Krystian-Matusiak/Praca_inzynierska/Kitchen_Hall_Garage_Rooms.pdf

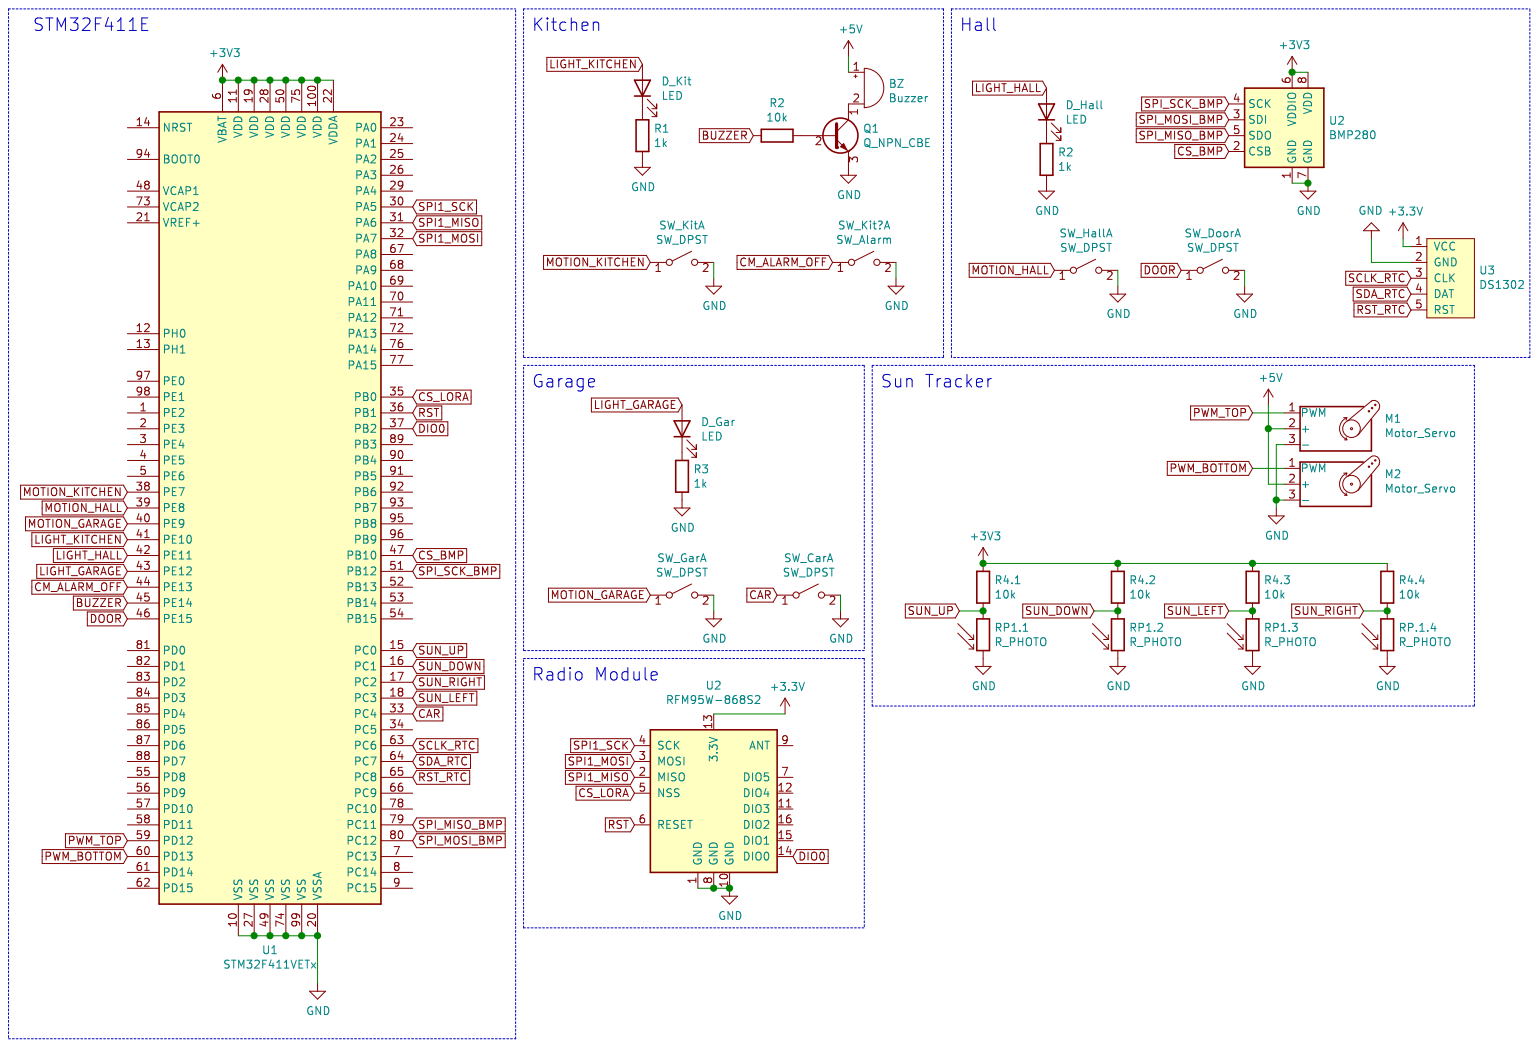
[picture p22: page 1]
