Krystian-Matusiak/Praca_inzynierska/Living_Bath_Bed_Rooms.pdf

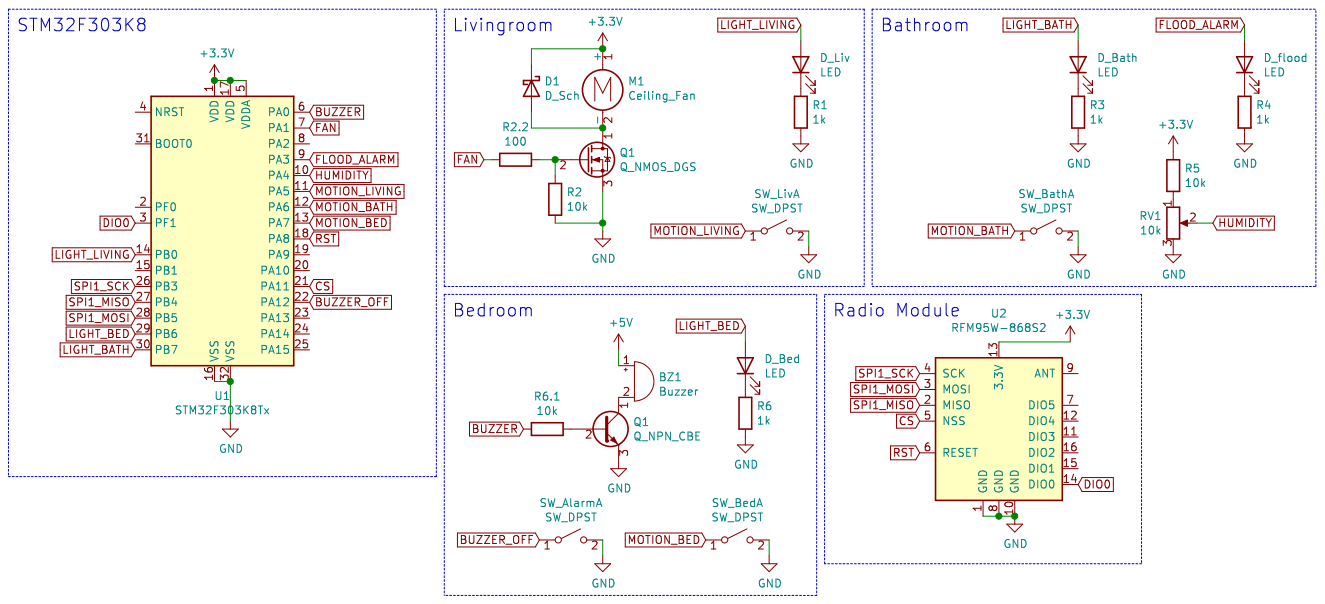
[picture p23: page 1]
