Krystian-Matusiak/Praca_inzynierska/SCHEMES/First_scheme/First_scheme.pdf

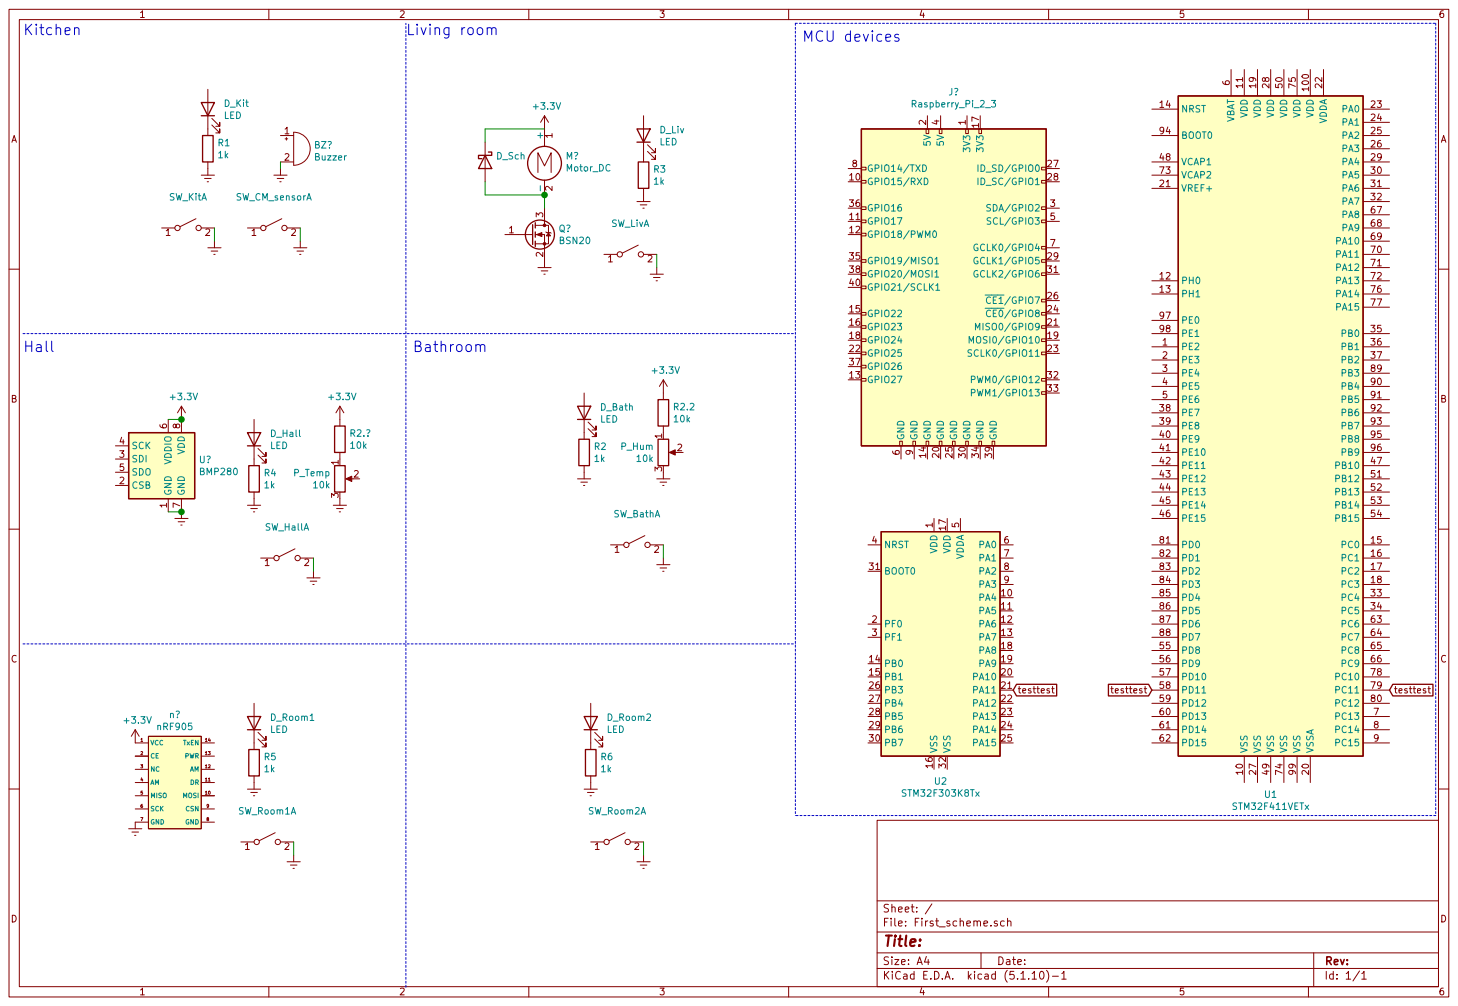
[picture p24: page 1]
