Krystian-Matusiak/Praca_inzynierska/Kitchen_Hall_Garage_Rooms/Core/Src/main.c

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
/* Includes ------------------------------------------------------------------*/
#include "main.h"
#include "cmsis_os.h"
#include "adc.h"
#include "dma.h"
#include "spi.h"
#include "tim.h"
#include "usart.h"
#include "gpio.h"

/* USER CODE BEGIN Includes */
#include "FreeRTOS.h"
#include "task.h"
#include "LoRa.h"
#include "bmp280.h"
#include "RTC.h"

/* USER CODE END Includes */

/* USER CODE BEGIN PD */

#define STM32F411_DEVICE 0x02

/* USER CODE END PD */


/* USER CODE BEGIN PV */

// -------------------------------------
// Task handlers

xTaskHandle light_kit_handle;
xTaskHandle light_hall_handle;
xTaskHandle light_gar_handle;
xTaskHandle carbon_sensor_handle;
xTaskHandle clock_handle;
xTaskHandle door_handle;
xTaskHandle car_handle;
xTaskHandle pressure_handle;
xTaskHandle sun_tracker_handle;
xTaskHandle tx_handle;
xTaskHandle rx_handle;


// -------------------------------------
// PID and sun tracker variables

typedef struct Servo{
	uint8_t Kp;
	uint8_t Ki;
	uint8_t Kd;

	int16_t P;
	int16_t I;
	int16_t D;

	int16_t error;
	int16_t prev_error;
}Servo;

Servo Top;
Servo Bottom;

void servo_init(){
	Top.Kp = 1;
	Top.Ki = 1;
	Top.Kd = 1;
	Top.error = 0;
	Top.prev_error = 0;


	Bottom.Kp = 1;
	Bottom.Ki = 1;
	Bottom.Kd = 1;
	Bottom.error = 0;
	Bottom.prev_error = 0;
}

int16_t positionTOP = 0;
int16_t positionBOTTOM = 0;

// -------------------------------------
// Boolean variables

uint8_t isKitchenEmpty=0;
uint8_t isHallEmpty=0;
uint8_t isGarageEmpty=0;
uint8_t isCar=0;
uint8_t isCMSensor=0;
uint8_t isDoorClosed=0;


// -------------------------------------
// Variables related with temperature, pressure and ph_resis

int32_t temp ;
uint32_t press;

volatile uint8_t ph_resis[4];

// -------------------------------------
// Variables related with data and time

uint8_t hours=0;
uint8_t minutes=0;
uint8_t seconds=1;

uint8_t day=0;
uint8_t month=0;
uint8_t year=0;
uint8_t day_week=0;

// -------------------------------------
// Transmit and receive buffor

// -----------------------------------------------------------------------
// tx_frame : | device | pressure | temp | clock | car | kitchen | hall | garage | CMS | door | PWM TOP | PWM BOTTOM |
//				  8bit      16bit	8bit   5x8bit  1bit   1bit	   1bit	  1bit	   1bit  1bit     8bit		8bit

uint8_t tx_frame[15]={0x02, 0x00, 0x00, 0x00, 0x00, 0x00, 0x00, 0x00, 0x00, 0x00, 0x00, 0x00, 0x00, 0x00, 0x00};
uint8_t rx_frame[6]={0x00, 0x00, 0x00, 0x00, 0x00, 0x00};

char tx_test[256] = "TEST FreeRTOS 411!      ";

// Continuous updatable time buffor
uint8_t buffor[8] = {0,1,2,3,4,5,6,7};
// Current time send

uint8_t real_time[8] = { 1 , 21 , 7 , 3 , 9 , 57 , 0 ,2 };


/* USER CODE END PV */

void SystemClock_Config(void);
void MX_FREERTOS_Init(void);
/* USER CODE BEGIN PFP */

void light_kitchen	(void *pvParameters);
void light_hall		(void *pvParameters);
void light_garage	(void *pvParameters);
void carbon_sensor	(void *pvParameters);
void clock			(void *pvParameters);
void door 			(void *pvParameters);
void car 			(void *pvParameters);
void pressure		(void *pvParameters);
void sun_tracker	(void *pvParameters);

void TX_radio		(void *pvParameters);
void RX_radio		(void *pvParameters);

/* USER CODE END PFP */

/* USER CODE BEGIN 0 */

void light_kitchen	(void *pvParameters){
	while(1){

		isKitchenEmpty = HAL_GPIO_ReadPin(MOTION_KIT_GPIO_Port, MOTION_KIT_Pin);

		if( !isKitchenEmpty ){
			HAL_GPIO_WritePin(LIGHT_KIT_GPIO_Port, LIGHT_KIT_Pin, GPIO_PIN_SET);
			tx_frame[10] = tx_frame[10] | (1<<4);
		}
		else{
			HAL_GPIO_WritePin(LIGHT_KIT_GPIO_Port, LIGHT_KIT_Pin, GPIO_PIN_RESET);
			tx_frame[10] = tx_frame[10] & ~(1<<4);
		}
		vTaskDelay( 10 / portTICK_PERIOD_MS);

	}
	vTaskDelete(NULL);
}

void light_hall		(void *pvParameters){
	while(1){

		isHallEmpty = HAL_GPIO_ReadPin(MOTION_HALL_GPIO_Port, MOTION_HALL_Pin);

		if( !isHallEmpty ){
			HAL_GPIO_WritePin(LIGHT_HALL_GPIO_Port, LIGHT_HALL_Pin, GPIO_PIN_SET);
			tx_frame[10] = tx_frame[10] | (1<<3);
		}
		else{
			HAL_GPIO_WritePin(LIGHT_HALL_GPIO_Port, LIGHT_HALL_Pin, GPIO_PIN_RESET);
			tx_frame[10] = tx_frame[10] & ~(1<<3);
		}
		vTaskDelay( 10 / portTICK_PERIOD_MS);
	}
	vTaskDelete(NULL);
}

void light_garage	(void *pvParameters){
	while(1){

		isGarageEmpty = HAL_GPIO_ReadPin(MOTION_GAR_GPIO_Port, MOTION_GAR_Pin);

		if( !isGarageEmpty ){
			HAL_GPIO_WritePin(LIGHT_GAR_GPIO_Port, LIGHT_GAR_Pin, GPIO_PIN_SET);
			tx_frame[10] = tx_frame[10] | (1<<2);
		}
		else{
			HAL_GPIO_WritePin(LIGHT_GAR_GPIO_Port, LIGHT_GAR_Pin, GPIO_PIN_RESET);
			tx_frame[10] = tx_frame[10] & ~(1<<2);
		}
		vTaskDelay( 10 / portTICK_PERIOD_MS);

	}
	vTaskDelete(NULL);
}

void carbon_sensor	(void *pvParameters){
	while(1){

		isCMSensor = HAL_GPIO_ReadPin(CMS_GPIO_Port, CMS_Pin);

		if( !isCMSensor ){
			HAL_GPIO_WritePin(CM_BUZZER_GPIO_Port, CM_BUZZER_Pin, GPIO_PIN_SET);
			tx_frame[10] = tx_frame[10] | (1<<1);
		}
		else{
			HAL_GPIO_WritePin(CM_BUZZER_GPIO_Port, CM_BUZZER_Pin, GPIO_PIN_RESET);
			tx_frame[10] = tx_frame[10] & ~(1<<1);
		}
		vTaskDelay( 5 / portTICK_PERIOD_MS);
	}
	vTaskDelete(NULL);
}

void clock			(void *pvParameters){
	while(1){
		Read_Time(buffor);

		year = buffor[1];
		month = buffor[2];
		day = buffor[7];

		hours = buffor[4];
		minutes = buffor[5];
		seconds = buffor[6];

//		year = 21;
//		month = 8;
//		day = 24;
//
//		hours = 9;
//		minutes = 1;

		tx_frame[4] = hours;
		tx_frame[5] = minutes;
		tx_frame[6] = seconds;
		tx_frame[7] = day;
		tx_frame[8] = month;
		tx_frame[9] = year;
//		seconds ++;
//		if(seconds == 60){
//			seconds=0;
//			minutes++;
//		}

//		printf("%d:%d:%d %d-%d-20%d \r\n",hours,minutes,seconds,day,month,year);
		vTaskDelay( 100 / portTICK_PERIOD_MS);
	}
	vTaskDelete(NULL);
}

void door 			(void *pvParameters){
	while(1){
		isDoorClosed = HAL_GPIO_ReadPin(DOOR_GPIO_Port, DOOR_Pin);
		if( !isDoorClosed ){
			tx_frame[10] = tx_frame[10] | (1<<5);
		}
		else{
			tx_frame[10] = tx_frame[10] & ~(1<<5);
		}
		vTaskDelay( 5 / portTICK_PERIOD_MS);
	}
	vTaskDelete(NULL);
}

void car 			(void *pvParameters){
	while(1){
		isCar = HAL_GPIO_ReadPin(CAR_GPIO_Port, CAR_Pin);
		if( !isCar )
			tx_frame[10] = tx_frame[10] | 1;
		else
			tx_frame[10] = tx_frame[10] & ~1;
		vTaskDelay( 5 / portTICK_PERIOD_MS);
	}
	vTaskDelete(NULL);
}

void pressure		(void *pvParameters){
	while(1){
		get_temp_press( &temp, &press);
		tx_frame[1] = (uint8_t)(press>>8);
		tx_frame[2] = (uint8_t)press;
		tx_frame[3] = (uint8_t)temp;

//		tx_frame[1] = 0x03;// (press>>8);
//		tx_frame[2] = 0xEF;// (uint8_t)press;
//		tx_frame[3] = 22;//temp;

//		printf("temp=%d \t cis=%d \r\n" , (int)temp , (int)press);
		vTaskDelay( 20 / portTICK_PERIOD_MS);
	}
	vTaskDelete(NULL);
}

void sun_tracker	(void *pvParameters){
	while(1){

		//-----------------------------------------------------------------
		// TOP

		Top.error = 0 - (ph_resis[0] - ph_resis[1]);

		Top.P = Top.Kp * Top.error;
		Top.I = Top.Ki * (Top.error - Top.prev_error);
		Top.D = Top.Kd * Top.error;

		Top.prev_error = Top.error;

		positionTOP += Top.P + Top.I;

		__HAL_TIM_SET_COMPARE(&htim1 , TIM_CHANNEL_1 , positionTOP );
		vTaskDelay( 20 / portTICK_PERIOD_MS);
		tx_frame[11] = positionTOP;

		//-----------------------------------------------------------------
		//BOTTOM

		Bottom.error = 0 - (ph_resis[2] - ph_resis[3]);

		Bottom.P = Bottom.Kp * Bottom.error;
		Bottom.I = Bottom.Ki * (Bottom.error - Bottom.prev_error);
		Bottom.D = Bottom.Kd * Bottom.error;

		Bottom.prev_error = Bottom.error;

		positionBOTTOM += Bottom.P + Bottom.I;

		__HAL_TIM_SET_COMPARE(&htim1 , TIM_CHANNEL_1 , positionBOTTOM );
		vTaskDelay( 20 / portTICK_PERIOD_MS);
		tx_frame[13] = positionBOTTOM;
	}
	vTaskDelete(NULL);
}


void TX_radio(void *pvParameters){
	vTaskDelay(30 / portTICK_PERIOD_MS);
	uint32_t time=0;
	while(1){

		time = HAL_GetTick();
		while( HAL_GetTick() - time < 5 ){
			Transmit(tx_frame, sizeof(tx_frame));
		}
//		Transmit(tx_frame, sizeof(tx_frame));
//		printf("test \r\n");

		vTaskResume(rx_handle);
		vTaskSuspend( NULL );
	}
	vTaskDelete(NULL);
}


void RX_radio(void *pvParameters){
	uint32_t time=0;
	set_OPMODE(OPMODE_RX);
	while(1){
		vTaskSuspend(tx_handle);

		set_OPMODE(OPMODE_RX);
		while(	HAL_GPIO_ReadPin(DIO0_GPIO_Port, DIO0_Pin) != GPIO_PIN_SET){}

		if( HAL_GPIO_ReadPin(DIO0_GPIO_Port, DIO0_Pin) == GPIO_PIN_SET ){
			Receive(rx_frame);
//			printf("Carrier found. \r\n");

			if( rx_frame[0] == 0x01 && rx_frame[1] == STM32F411_DEVICE){
				vTaskResume(tx_handle);
				vTaskSuspend( NULL );

				Write_Reg(REG_HOP_PERIOD,0x00);
				Write_Reg(RegDioMapping1, MAP_DIO0_LORA_RXDONE|MAP_DIO1_LORA_NOP|MAP_DIO2_LORA_NOP);
				Write_Reg(REG_IRQ_FLAGS, 0xFF);
				Write_Reg(REG_IRQ_FLAGS_MASK, ~IRQ_LORA_RXDONE_MASK);
				Write_Reg(REG_FIFO_RX_BASE_AD, 0x00);
				Write_Reg(REG_FIFO_ADDR_PTR, 0x00);
			}
			printf("RPI data = %d - %d - %d \r\n" , rx_frame[0], rx_frame[1], rx_frame[2]);
		}
		else{
			printf("No carrier found. \r\n");
		}
		rx_frame[0]=0x00;
		rx_frame[1]=0x00;

	}
	vTaskDelete(NULL);
}




/* USER CODE END 0 */

/**
  * @brief  The application entry point.
  * @retval int
  */
int main(void)
{
  /* MCU Configuration--------------------------------------------------------*/

  /* Reset of all peripherals, Initializes the Flash interface and the Systick. */
  HAL_Init();

  /* Configure the system clock */
  SystemClock_Config();

  /* Initialize all configured peripherals */
  MX_GPIO_Init();
  MX_SPI1_Init();
  MX_DMA_Init();
  MX_ADC1_Init();
  MX_USART2_UART_Init();
  MX_SPI3_Init();
  MX_TIM4_Init();
  /* USER CODE BEGIN 2 */

  // Sun tracker (PWM and ADC) init
//  HAL_TIM_PWM_Start(&htim1, TIM_CHANNEL_1);
//  HAL_TIM_PWM_Start(&htim1, TIM_CHANNEL_2);
//  HAL_ADC_Start_DMA(&hadc1, ph_resis, 4);

  // Setting up BMP280
  reset();
  BMP280_setup();
  setConstants();

  // Setting up Real Time Clock
  RTC_Init();
  Write_Zero_Seconds();

  // Servo struct definition
  servo_init();

  // Setting up LoRa
  LoRa_init(868);
  tx_frame[0] = STM32F411_DEVICE;



  xTaskCreate( TX_radio			, "RADIO_TRANSMIT_TASK"		, 250, NULL, 1, &tx_handle );
  xTaskCreate( RX_radio			, "RADIO_RECEIVE_TASK"		, 250, NULL, 1, &rx_handle );
  xTaskCreate( pressure			, "PRESSURE_TASK"			, 230, NULL, 1, &pressure_handle );
  xTaskCreate( clock			, "CLOCK_TASK"				, 220, NULL, 1, &clock_handle );

  xTaskCreate( door				, "DOOR_TASK"				, 90, NULL, 1, &door_handle );
  xTaskCreate( car				, "CAR_TASK"				, 90, NULL, 1, &car_handle );
  xTaskCreate( carbon_sensor	, "CARBON_SENSOR_TASK" 		, 100, NULL, 1, &carbon_sensor_handle );

  xTaskCreate( light_kitchen	, "LIGHT_KITCHEN_TASK"		, 70, NULL, 1, &light_kit_handle );
  xTaskCreate( light_hall		, "LIGHT_HALL_TASK"			, 70, NULL, 1, &light_hall_handle );
  xTaskCreate( light_garage		, "LIGHT_GARAGE_TASK"		, 70, NULL, 1, &light_gar_handle );

//  xTaskCreate( sun_tracker		, "SUN_TRACKER_TASK"		, 150, NULL, 1, &sun_tracker_handle);

  vTaskStartScheduler();

  /* USER CODE END 2 */

  /* Init scheduler */
  osKernelInitialize();  /* Call init function for freertos objects (in freertos.c) */
  MX_FREERTOS_Init();
  /* Start scheduler */
  osKernelStart();

  /* We should never get here as control is now taken by the scheduler */
  /* Infinite loop */
  /* USER CODE BEGIN WHILE */


  while (1)
  {
	vTaskDelay( 10 / portTICK_PERIOD_MS);

    /* USER CODE END WHILE */

    /* USER CODE BEGIN 3 */
  }
  /* USER CODE END 3 */
}

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
