Krystian-Matusiak/Praca_inzynierska/Kitchen_Hall_Garage_Rooms/Core/Inc/main.h

#define SUN_UP_Pin GPIO_PIN_0
#define SUN_UP_GPIO_Port GPIOC
#define SUN_DOWN_Pin GPIO_PIN_1
#define SUN_DOWN_GPIO_Port GPIOC
#define SUN_RIGHT_Pin GPIO_PIN_2
#define SUN_RIGHT_GPIO_Port GPIOC
#define SUN_LEFT_Pin GPIO_PIN_3
#define SUN_LEFT_GPIO_Port GPIOC
#define CAR_Pin GPIO_PIN_4
#define CAR_GPIO_Port GPIOC
#define CS_LORA_Pin GPIO_PIN_0
#define CS_LORA_GPIO_Port GPIOB
#define RST_Pin GPIO_PIN_1
#define RST_GPIO_Port GPIOB
#define DIO0_Pin GPIO_PIN_2
#define DIO0_GPIO_Port GPIOB
#define MOTION_KIT_Pin GPIO_PIN_7
#define MOTION_KIT_GPIO_Port GPIOE
#define MOTION_HALL_Pin GPIO_PIN_8
#define MOTION_HALL_GPIO_Port GPIOE
#define MOTION_GAR_Pin GPIO_PIN_9
#define MOTION_GAR_GPIO_Port GPIOE
#define LIGHT_KIT_Pin GPIO_PIN_10
#define LIGHT_KIT_GPIO_Port GPIOE
#define LIGHT_HALL_Pin GPIO_PIN_11
#define LIGHT_HALL_GPIO_Port GPIOE
#define LIGHT_GAR_Pin GPIO_PIN_12
#define LIGHT_GAR_GPIO_Port GPIOE
#define CMS_Pin GPIO_PIN_13
#define CMS_GPIO_Port GPIOE
#define CM_BUZZER_Pin GPIO_PIN_14
#define CM_BUZZER_GPIO_Port GPIOE
#define DOOR_Pin GPIO_PIN_15
#define DOOR_GPIO_Port GPIOE
#define CS_BMP_Pin GPIO_PIN_10
#define CS_BMP_GPIO_Port GPIOB
#define PWM_TOP_Pin GPIO_PIN_12
#define PWM_TOP_GPIO_Port GPIOD
#define PWM_BOTTOM_Pin GPIO_PIN_13
#define PWM_BOTTOM_GPIO_Port GPIOD
#define SCLK_RTC_Pin GPIO_PIN_6
#define SCLK_RTC_GPIO_Port GPIOC
#define SDA_RTC_Pin GPIO_PIN_7
#define SDA_RTC_GPIO_Port GPIOC
#define RST_RTC_Pin GPIO_PIN_8
#define RST_RTC_GPIO_Port GPIOC
