Krystian-Matusiak/Praca_inzynierska/Living_Bath_Bed_Rooms/Core/Src/main.c

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
/* Includes ------------------------------------------------------------------*/
#include "main.h"
#include "cmsis_os.h"
#include "adc.h"
#include "spi.h"
#include "tim.h"
#include "usart.h"
#include "gpio.h"

/* USER CODE BEGIN Includes */


#include <stdio.h>
#include <string.h>
#include <semphr.h>
#include "FreeRTOS.h"
#include "task.h"
#include "LoRa.h"

/* USER CODE END Includes */

/* USER CODE BEGIN PD */

#define TEMP_THRESHOLD 24
#define HUMID_THRESHOLD 80

#define STM32F303K8_DEVICE 0x03

/* USER CODE END PD */


/* USER CODE BEGIN PV */

// -------------------------------------
// Task handlers

xTaskHandle light_liv_handle;
xTaskHandle light_bed_handle;
xTaskHandle light_bath_handle;
xTaskHandle light_fl_handle;
xTaskHandle light_alarm_handle;
xTaskHandle radio_module_handle;
xTaskHandle fan_handle;
xTaskHandle tx_handle;
xTaskHandle rx_handle;


// -------------------------------------
// Boolean variables

uint8_t isLivingroomEmpty=0;
uint8_t isBathroomEmpty=0;
uint8_t isBedroomEmpty=0;
uint8_t isFlood=0;
uint8_t isAlarmOn=0;
uint8_t isAlarmOff=0;


// -------------------------------------
// Variables related with temperature and humidity

uint8_t temperature=0;

uint8_t humidity_measure=0;
uint8_t humidity=0;

// -------------------------------------
// Variables related with data and time

uint8_t hours=-1;
uint8_t minutes=-1;
uint8_t day=-1;
uint8_t month=-1;

uint8_t alarm_hours=0;
uint8_t alarm_minutes=0;
uint8_t alarm_day=0;
uint8_t alarm_month=0;


// -------------------------------------
// Transmit and receive buffor

// -------------------------------------
// tx_frame : | device | humidity | livingroom | bathroom | bedroom | alarm switch-off | alarm active |  fan  |
//				  8bit      8bit	   	1bit		1bit		1bit		  1bit				1bit	 1bit

uint8_t tx_frame[3] = { 0x03 , 0x00 , 0b00000000 };
uint8_t rx_frame[15]= {0 ,0 ,0 ,0 ,0 ,0 ,0 ,0 ,0 ,0 ,0 ,0 ,0 ,0 ,0};

char tx_test[256] = "TEST FreeRTOS 303!      ";


// Continuous updatable time buffor
uint8_t buffor[8] = {0,1,2,3,4,5,6,7};

// Current time send
uint8_t real_time[8] = { 1 , 21 , 7 , 3 , 13 , 20 , 0 ,2};


//static SemaphoreHandle_t mutex;



/* USER CODE END PV */

void SystemClock_Config(void);
void MX_FREERTOS_Init(void);
/* USER CODE BEGIN PFP */
void light_livingroom   (void *pvParameters);
void light_bathroom   	(void *pvParameters);
void light_bedroom   	(void *pvParameters);
void ceiling_fan		(void *pvParameters);
void flood_protection 	(void *pvParameters);
void alarm_clock		(void *pvParameters);
void radio_module		(void *pvParameters);

void TX_radio		(void *pvParameters);
void RX_radio		(void *pvParameters);


/* USER CODE END PFP */

/* USER CODE BEGIN 0 */



void light_livingroom   (void *pvParameters){
	while(1){

		isLivingroomEmpty = HAL_GPIO_ReadPin(MOTION_LIVING_GPIO_Port, MOTION_LIVING_Pin);

		if( !isLivingroomEmpty ){
			HAL_GPIO_WritePin(LIGHT_LIVING_GPIO_Port, LIGHT_LIVING_Pin, GPIO_PIN_SET);
			tx_frame[2] = tx_frame[2] | (1<<5);
		}
		else{
			HAL_GPIO_WritePin(LIGHT_LIVING_GPIO_Port, LIGHT_LIVING_Pin, GPIO_PIN_RESET);
			tx_frame[2] = tx_frame[2] & ~(1<<5);
		}
		vTaskDelay( 10 / portTICK_PERIOD_MS);
	}
	vTaskDelete(NULL);
}
int a=0;
void light_bathroom   	(void *pvParameters){
	while(1){

		isBathroomEmpty = HAL_GPIO_ReadPin(MOTION_BATH_GPIO_Port, MOTION_BATH_Pin);

		if( !isBathroomEmpty ){
			HAL_GPIO_WritePin(LIGHT_BATH_GPIO_Port, LIGHT_BATH_Pin, GPIO_PIN_SET);
			tx_frame[2] = tx_frame[2] | (1<<4);
		}
		else{
			HAL_GPIO_WritePin(LIGHT_BATH_GPIO_Port, LIGHT_BATH_Pin, GPIO_PIN_RESET);
			tx_frame[2] = tx_frame[2] & ~(1<<4);
		}
		vTaskDelay( 10 / portTICK_PERIOD_MS);
	}
	vTaskDelete(NULL);
}

void light_bedroom   	(void *pvParameters){
	while(1){

		isBedroomEmpty = HAL_GPIO_ReadPin(MOTION_BED_GPIO_Port, MOTION_BED_Pin);

		if( !isBedroomEmpty ){
			HAL_GPIO_WritePin(LIGHT_BED_GPIO_Port, LIGHT_BED_Pin, GPIO_PIN_SET);
			tx_frame[2] = tx_frame[2] | (1<<3);
		}
		else{
			HAL_GPIO_WritePin(LIGHT_BED_GPIO_Port, LIGHT_BED_Pin, GPIO_PIN_RESET);
			tx_frame[2] = tx_frame[2] & ~(1<<3);
		}
		vTaskDelay( 10 / portTICK_PERIOD_MS);
	}
	vTaskDelete(NULL);
}



void ceiling_fan 	 	(void *pvParameters){
	while(1){
		if( temperature > TEMP_THRESHOLD ){
			HAL_GPIO_WritePin(FAN_GPIO_Port, FAN_Pin, GPIO_PIN_SET);
			tx_frame[2] = tx_frame[2] | 1;
		}
		else{
			HAL_GPIO_WritePin(FAN_GPIO_Port, FAN_Pin, GPIO_PIN_RESET);
			tx_frame[2] = tx_frame[2] & ~1;
		}

		vTaskDelay( 10 / portTICK_PERIOD_MS);
	}
	vTaskDelete(NULL);
}

void flood_protection 	(void *pvParameters){
	while(1){
		  HAL_ADC_Start(&hadc2);
		  vTaskDelay( 10 / portTICK_PERIOD_MS);

		  //humidity_measure = HAL_ADC_GetValue(&hadc2);
		  humidity = (HAL_ADC_GetValue(&hadc2) * 70)/113 + 20;

		  if(humidity > 90)
			  humidity = 90;

		  if( humidity >= 50)
			HAL_GPIO_WritePin(FLOOD_ALARM_GPIO_Port, FLOOD_ALARM_Pin, GPIO_PIN_SET);
		  else
			HAL_GPIO_WritePin(FLOOD_ALARM_GPIO_Port, FLOOD_ALARM_Pin, GPIO_PIN_RESET);

//		if( rx_frame[0] == 0x02){
//			printf("STM32F411 data = %d - %d - %d - %d \r\n" , rx_frame[4], rx_frame[5], rx_frame[8], rx_frame[7]);
//			printf("alarm = %d - %d - %d - %d\r\n" , alarm_day, alarm_month, alarm_hours, alarm_minutes);
//		}
	}
	vTaskDelete(NULL);
}

void alarm_clock		(void *pvParameters){
	while(1){

		if( 	!isAlarmOff
				&& day == alarm_day
				&& month == alarm_month
				&& hours == alarm_hours
				&& minutes == alarm_minutes
				&& HAL_GPIO_ReadPin(BUZZER_OFF_GPIO_Port, BUZZER_OFF_Pin) != GPIO_PIN_RESET){

			HAL_GPIO_WritePin(BUZZER_GPIO_Port, BUZZER_Pin, GPIO_PIN_SET);
			tx_frame[2] = tx_frame[2] | (1<<1);
			isAlarmOn=1;
		}
		if(		day != alarm_day
				&& month != alarm_month
				&& hours != alarm_hours
				&& minutes != alarm_minutes
				){
			isAlarmOff=0;
			tx_frame[2] = tx_frame[2] & ~(1<<2);
		}

		if( isAlarmOn && HAL_GPIO_ReadPin(BUZZER_OFF_GPIO_Port, BUZZER_OFF_Pin) == GPIO_PIN_RESET ){
			HAL_GPIO_WritePin(BUZZER_GPIO_Port, BUZZER_Pin, GPIO_PIN_RESET);
			tx_frame[2] = tx_frame[2] | (1<<2);
			tx_frame[2] = tx_frame[2] & ~(1<<1);
			isAlarmOff = 1;
			isAlarmOn  = 0;

			alarm_day=0;
			alarm_month=0;
			alarm_hours=0;
			alarm_minutes=0;

			vTaskDelay( 200 / portTICK_PERIOD_MS);
//			alarm_off=0;
		}

		vTaskDelay( 10 / portTICK_PERIOD_MS);
	}
	vTaskDelete(NULL);
}

void TX_radio(void *pvParameters){
	vTaskDelay(30 / portTICK_PERIOD_MS);
	uint32_t time=0;
	while(1){

		tx_frame[1] = humidity;
		time = HAL_GetTick();
		while( HAL_GetTick() - time < 5 ){
			Transmit(tx_frame, sizeof(tx_frame));
		}

//		HAL_GPIO_WritePin(LIGHT_BATH_GPIO_Port, LIGHT_BATH_Pin, GPIO_PIN_SET);

		vTaskResume(rx_handle);
		vTaskSuspend( NULL );
		vTaskDelay( 1/ portTICK_PERIOD_MS);
	}
	vTaskDelete(NULL);
}

void RX_radio(void *pvParameters){
	uint32_t time=0;
	set_OPMODE(OPMODE_RX);
	while(1){
		vTaskSuspend(tx_handle);

		set_OPMODE(OPMODE_RX);
		while(	HAL_GPIO_ReadPin(DIO0_GPIO_Port, DIO0_Pin) != GPIO_PIN_SET){
//			printf("Waiting \r\n");
		}

		if( HAL_GPIO_ReadPin(DIO0_GPIO_Port, DIO0_Pin) == GPIO_PIN_SET ){
			Receive(rx_frame);

			if( rx_frame[0] == 0x02 ){
				day=rx_frame[7];
				month=rx_frame[8];
				hours=rx_frame[4];
				minutes=rx_frame[5];

				temperature=rx_frame[3];
				printf("\nSTM32F411 data = %d - %d - %d - %d \r\n" , rx_frame[4], rx_frame[5], rx_frame[8], rx_frame[7]);

			}

			if( rx_frame[0] == 0x01 && rx_frame[1] == STM32F303K8_DEVICE){

				if( !isAlarmOff){
					alarm_day=rx_frame[2];
					alarm_month=rx_frame[3];
					alarm_hours=rx_frame[4];
					alarm_minutes=rx_frame[5];
				}

				vTaskResume(tx_handle);
				vTaskSuspend( NULL );

				Write_Reg(REG_HOP_PERIOD,0x00);
				Write_Reg(RegDioMapping1, MAP_DIO0_LORA_RXDONE|MAP_DIO1_LORA_NOP|MAP_DIO2_LORA_NOP);
				Write_Reg(REG_IRQ_FLAGS, 0xFF);
				Write_Reg(REG_IRQ_FLAGS_MASK, ~IRQ_LORA_RXDONE_MASK);
				Write_Reg(REG_FIFO_RX_BASE_AD, 0x00);
				Write_Reg(REG_FIFO_ADDR_PTR, 0x00);

				printf("alarm = %d - %d - %d - %d\r\n\n" , alarm_day, alarm_month, alarm_hours, alarm_minutes);
			}
		}
		else{
			printf("No carrier found. \r\n");
		}
		rx_frame[0]=0x00;
		rx_frame[1]=0x00;

		vTaskDelay(5 / portTICK_PERIOD_MS);
	}
	vTaskDelete(NULL);
}


/* USER CODE END 0 */

/**
  * @brief  The application entry point.
  * @retval int
  */
int main(void)
{
  /* MCU Configuration--------------------------------------------------------*/

  /* Reset of all peripherals, Initializes the Flash interface and the Systick. */
  HAL_Init();

  /* Configure the system clock */
  SystemClock_Config();

  /* Initialize all configured peripherals */
  MX_GPIO_Init();
  MX_SPI1_Init();
  MX_ADC2_Init();
  MX_USART1_UART_Init();
  MX_TIM6_Init();
  /* USER CODE BEGIN 2 */


  // Start ADC
  HAL_ADC_Start(&hadc2);

  // Buzzer OFF
  HAL_GPIO_WritePin(BUZZER_GPIO_Port, BUZZER_Pin, GPIO_PIN_RESET);

  // Setting up LoRa
  LoRa_init(868);
  tx_frame[0] = STM32F303K8_DEVICE;

  xTaskCreate( flood_protection , "FLOOD_PROTECTION_TASK"	, 180, NULL, 1, &light_fl_handle );
  xTaskCreate( TX_radio			, "RADIO_TRANSMIT_TASK"		, 150, NULL, 1, &tx_handle );
  xTaskCreate( RX_radio			, "RADIO_RECEIVE_TASK"		, 250, NULL, 1, &rx_handle );

  xTaskCreate( alarm_clock		, "ALARM_CLOCK_TASK"		, 90, NULL, 1, &light_alarm_handle );
  xTaskCreate( ceiling_fan		, "CEILING_FAN_TASK" 		, 90, NULL, 1, &fan_handle );

  xTaskCreate( light_livingroom	, "LIGHT_LIVINGROOM_TASK"	, 70, NULL, 1, &light_liv_handle );
  xTaskCreate( light_bathroom	, "LIGHT_BATHROOM_TASK"		, 70, NULL, 1, &light_bath_handle );
  xTaskCreate( light_bedroom	, "LIGHT_BEDROOM_TASK"		, 70, NULL, 1, &light_bed_handle );



  vTaskStartScheduler();

  /* USER CODE END 2 */

  /* Init scheduler */
  osKernelInitialize();  /* Call init function for freertos objects (in freertos.c) */
  MX_FREERTOS_Init();
  /* Start scheduler */
  osKernelStart();

  /* We should never get here as control is now taken by the scheduler */
  /* Infinite loop */
  /* USER CODE BEGIN WHILE */



  while (1)
  {
	vTaskDelay( 2 / portTICK_PERIOD_MS);

    /* USER CODE END WHILE */

    /* USER CODE BEGIN 3 */
  }
  /* USER CODE END 3 */
}

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
