Krystian-Matusiak/Praca_inzynierska/Modules/LoRa_303/Core/Src/main.c

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
/* Includes ------------------------------------------------------------------*/
#include "main.h"
#include "spi.h"
#include "usart.h"
#include "gpio.h"

/* USER CODE BEGIN PD */


// Registers

#define REG_FIFO                    0x00
#define REG_OPMODE                  0x01

#define REG_FIFO_ADDR_PTR           0x0D
#define REG_FIFO_TX_BASE_AD         0x0E
#define REG_FIFO_RX_BASE_AD         0x0F

#define REG_RX_NB_BYTES             0x13
#define REG_FIFO_RX_CURRENT_ADDR    0x10
#define REG_IRQ_FLAGS               0x12
#define REG_DIO_MAPPING_1           0x40
#define REG_DIO_MAPPING_2           0x41
#define REG_MODEM_CONFIG            0x1D
#define REG_MODEM_CONFIG2           0x1E
#define REG_MODEM_CONFIG3           0x26
#define REG_SYMB_TIMEOUT_LSB  		0x1F
#define REG_PKT_SNR_VALUE			0x19
#define REG_PAYLOAD_LENGTH          0x22
#define REG_IRQ_FLAGS_MASK          0x11
#define REG_MAX_PAYLOAD_LENGTH 		0x23
#define REG_HOP_PERIOD              0x24
#define REG_SYNC_WORD				0x39
#define REG_VERSION	  				0x42

#define PAYLOAD_LENGTH              0x40


// ----------------------------------------
// Constants for radio registers
#define OPMODE_LORA      0x80
#define OPMODE_MASK      0x07
#define OPMODE_SLEEP     0x00
#define OPMODE_STANDBY   0x01
#define OPMODE_FSTX      0x02
#define OPMODE_TX        0x03
#define OPMODE_FSRX      0x04
#define OPMODE_RX        0x05
#define OPMODE_RX_SINGLE 0x06
#define OPMODE_CAD       0x07


// FRF
#define        REG_FRF_MSB              0x06
#define        REG_FRF_MID              0x07
#define        REG_FRF_LSB              0x08

#define        FRF_MSB                  0xD9 // 868.1 Mhz
#define        FRF_MID                  0x06
#define        FRF_LSB                  0x66


// ----------------------------------------
// Bits masking the corresponding IRQs from the radio
#define IRQ_LORA_RXTOUT_MASK 0x80
#define IRQ_LORA_RXDONE_MASK 0x40
#define IRQ_LORA_CRCERR_MASK 0x20
#define IRQ_LORA_HEADER_MASK 0x10
#define IRQ_LORA_TXDONE_MASK 0x08
#define IRQ_LORA_CDDONE_MASK 0x04
#define IRQ_LORA_FHSSCH_MASK 0x02
#define IRQ_LORA_CDDETD_MASK 0x01


// DIO function mappings                D0D1D2D3
#define MAP_DIO0_LORA_RXDONE   0x00  // 00------
#define MAP_DIO0_LORA_TXDONE   0x40  // 01------
#define MAP_DIO1_LORA_RXTOUT   0x00  // --00----
#define MAP_DIO1_LORA_NOP      0x30  // --11----
#define MAP_DIO2_LORA_NOP      0xC0  // ----11--

// LOW NOISE AMPLIFIER
#define REG_LNA			0x0C
#define LNA_MAX_GAIN	0x23
#define LNA_OFF_GAIN	0x00
#define LNA_LOW_GAIN	0x20

#define RegDioMapping1	0x40 // common
#define RegDioMapping2	0x41 // common

#define RegPaConfig		0x09 // common
#define RegPaRamp		0x0A // common
#define RegPaDac		0x5A // common


/* USER CODE END PD */


/* USER CODE BEGIN PV */

char rx_data[256];
char tx_data[256] = "Hello ! STM32F303K8 !";
unsigned char hello[32];// = "HELLO! ";

unsigned char receivedbytes;

/* USER CODE END PV */

void SystemClock_Config(void);
/* USER CODE BEGIN PFP */


void 	SPI_CS_LOW		();
void 	SPI_CS_HIGH		();

unsigned char Read_Reg		(unsigned char addr);
void 	Write_Reg		(unsigned char addr , unsigned char value);
void 	Write_Buf		(unsigned char addr, unsigned char *value, unsigned char len);

void 	set_OPMODE		(uint8_t mode);
void 	set_LoRa_mode	();
void 	set_Freq		(uint64_t freq);
void 	set_config		();
void 	set_Power		(int8_t pw);

uint8_t Receive		(char * payload);
void 	Transmit	(unsigned char *frame, unsigned char datalen);



/* USER CODE END PFP */

/* USER CODE BEGIN 0 */


int _write(int file , char *ptr , int len){
  HAL_UART_Transmit(&huart1 , ptr , len , 50);
  return len;
}

void SPI_CS_LOW(){
	HAL_GPIO_WritePin(CS_GPIO_Port, CS_Pin, GPIO_PIN_RESET);
}

void SPI_CS_HIGH(){
	HAL_GPIO_WritePin(CS_GPIO_Port, CS_Pin, GPIO_PIN_SET);
}

unsigned char Read_Reg(unsigned char addr){
	uint8_t reg = addr & 0x7F;
	uint8_t data;

	SPI_CS_LOW();
	HAL_SPI_Transmit(&hspi1, &reg, 1 , HAL_MAX_DELAY);
	HAL_SPI_Receive(&hspi1, &data, 1, HAL_MAX_DELAY);
	SPI_CS_HIGH();

	return data;
}

void Write_Reg(unsigned char addr , unsigned char value){
	uint8_t reg = addr | 0x80;
	uint8_t Value = value;

	SPI_CS_LOW();
	HAL_SPI_Transmit(&hspi1, &reg,	1 , HAL_MAX_DELAY);
	HAL_SPI_Transmit(&hspi1, &Value,1 , HAL_MAX_DELAY);
	SPI_CS_HIGH();
}

void set_OPMODE(uint8_t mode){
	Write_Reg(REG_OPMODE, Read_Reg(REG_OPMODE) & ~OPMODE_MASK | mode );
}

void set_LoRa_mode(){
	set_OPMODE(OPMODE_SLEEP);
	HAL_Delay(15);

	uint8_t data = OPMODE_LORA;
	Write_Reg(REG_OPMODE, data);
}

void set_Freq(uint64_t freq){
	set_OPMODE(OPMODE_SLEEP);
	HAL_Delay(15);

	uint64_t frf = (( uint64_t)freq <<14 );  // freq *  2^19 / 32
	Write_Reg(REG_FRF_MSB, (uint8_t)(frf>>16) );
	Write_Reg(REG_FRF_MID, (uint8_t)(frf>>8) );
	Write_Reg(REG_FRF_LSB, (uint8_t)(frf>>0) );
}

void set_config(){
	set_OPMODE(OPMODE_SLEEP);
	HAL_Delay(15);

	set_LoRa_mode();

	unsigned char version = Read_Reg(REG_VERSION);

	printf("%d version \n\r", version);

	Write_Reg(REG_SYNC_WORD, 0x34);


	Write_Reg(REG_MODEM_CONFIG3,0x04);
	Write_Reg(REG_MODEM_CONFIG,0x72);
	Write_Reg(REG_MODEM_CONFIG2, (0x07<<4) | 0x04);

	Write_Reg(REG_SYMB_TIMEOUT_LSB,0x08);

	Write_Reg(REG_MAX_PAYLOAD_LENGTH, 0x80);
	Write_Reg(REG_PAYLOAD_LENGTH, PAYLOAD_LENGTH);
	Write_Reg(REG_HOP_PERIOD, 0xFF);
	Write_Reg(REG_FIFO_ADDR_PTR, Read_Reg(REG_FIFO_TX_BASE_AD));

	Write_Reg(REG_LNA, LNA_MAX_GAIN);
}

uint8_t Receive(char *payload){
	Write_Reg(REG_IRQ_FLAGS, 0x40);

	int IRQ = Read_Reg(REG_IRQ_FLAGS);

	if(( IRQ & 0x20) == 0x20){
		printf("CRC error \n\r");
		Write_Reg(REG_IRQ_FLAGS, 0x20);
		return 0;
	}
	else {
		uint8_t currentAddr = Read_Reg(REG_FIFO_RX_CURRENT_ADDR);
		uint8_t receivedCount = Read_Reg(REG_RX_NB_BYTES);
		receivedbytes = receivedCount;

		Write_Reg(REG_FIFO_ADDR_PTR, currentAddr);

		for(int i = 0; i < receivedCount; i++)
			payload[i] = (char)Read_Reg(REG_FIFO);
	}

	return 1;
}

void Write_Buf(unsigned char addr, unsigned char *value, unsigned char len) {

	uint8_t reg = addr | 0x80;
	uint8_t buf[256];
	for (int i = 0; i < len; i++) {
		buf[i] = value[i];
	}

	SPI_CS_LOW();
	HAL_SPI_Transmit(&hspi1, &reg, 1, HAL_MAX_DELAY);
	HAL_SPI_Transmit(&hspi1, buf, len, HAL_MAX_DELAY);
	SPI_CS_HIGH();
}

void Transmit(unsigned char *frame, unsigned char datalen) {

	Write_Reg(REG_HOP_PERIOD,0x00);
	Write_Reg(RegDioMapping1, MAP_DIO0_LORA_TXDONE|MAP_DIO1_LORA_NOP|MAP_DIO2_LORA_NOP);
	Write_Reg(REG_IRQ_FLAGS, 0xFF);
	Write_Reg(REG_IRQ_FLAGS_MASK, ~IRQ_LORA_TXDONE_MASK);

	Write_Reg(REG_FIFO_TX_BASE_AD, 0x00);
	Write_Reg(REG_FIFO_ADDR_PTR, 0x00);
	Write_Reg(REG_PAYLOAD_LENGTH, datalen);

	Write_Buf(REG_FIFO, frame, datalen);
	set_OPMODE(OPMODE_TX);
}

void set_Power(int8_t pw) {
	if(pw >= 17) {
		pw = 15;
	} else if(pw < 2) {
		pw = 2;
	}
	Write_Reg(RegPaConfig, (uint8_t)(0x80|(pw&0xf)));
	Write_Reg(RegPaDac, Read_Reg(RegPaDac)|0x4);

}


int receive2(char *payload, int * receivedbytes) {
	// clear rxDone
	Write_Reg(REG_IRQ_FLAGS, 0x40);



	int irqflags = Read_Reg(REG_IRQ_FLAGS);

	//  payload crc: 0x20
	if((irqflags & 0x20) == 0x20)
	{
		printf("CRC error\n");
		Write_Reg(REG_IRQ_FLAGS, 0x20);
		*receivedbytes = 0;
		return -1;
	} else {

		unsigned char currentAddr = Read_Reg(REG_FIFO_RX_CURRENT_ADDR);
		unsigned char receivedCount = Read_Reg(REG_RX_NB_BYTES);
		*receivedbytes = receivedCount;

		Write_Reg(REG_FIFO_ADDR_PTR, currentAddr);

		for(int i = 0; i < receivedCount; i++)
		{
			payload[i] = (char)Read_Reg(REG_FIFO);
		}
	}
	return 0;
}

void receivepacket2(char * buffer, int * receivedbytes, int * prssi, int * rssi, long int *snr, int *error) {
	int rssicorr;
	int ret;
	*error = 0;

	if( HAL_GPIO_ReadPin(DIO0_GPIO_Port, DIO0_Pin) == GPIO_PIN_SET ){
		ret = receive2(buffer, receivedbytes);
		printf("rec \r\n");
		if(ret == 0){
			unsigned char value = Read_Reg(REG_PKT_SNR_VALUE);
			if( value & 0x80 ) // The SNR sign bit is 1
			{
				// Invert and divide by 4
				value = ( ( ~value + 1 ) & 0xFF ) >> 2;
				*snr = -value;
			}
			else
			{
				// Divide by 4
				*snr = ( value & 0xFF ) >> 2;
			}


			rssicorr = 157;


			*prssi =  Read_Reg(0x1A)-rssicorr;
			*rssi = Read_Reg(0x1B)-rssicorr;
		}
		else {
			//CRC error
			*error = ret;
		}
	}
	else{
		*receivedbytes = 0;
		*prssi = 0;
		*rssi = 0;
		*snr = 0;
	}
}

/* USER CODE END 0 */

/**
  * @brief  The application entry point.
  * @retval int
  */
int main(void)
{
  /* MCU Configuration--------------------------------------------------------*/

  /* Reset of all peripherals, Initializes the Flash interface and the Systick. */
  HAL_Init();

  /* Configure the system clock */
  SystemClock_Config();

  /* Initialize all configured peripherals */
  MX_GPIO_Init();
  MX_SPI1_Init();
  MX_USART1_UART_Init();
  /* Infinite loop */
  /* USER CODE BEGIN WHILE */

  printf("Sending \n\n\n\r");
  HAL_GPIO_WritePin(RST_GPIO_Port, RST_Pin, GPIO_PIN_SET);
  HAL_Delay(100);
  HAL_GPIO_WritePin(RST_GPIO_Port, RST_Pin, GPIO_PIN_RESET);
  HAL_Delay(100);
  HAL_GPIO_WritePin(RST_GPIO_Port, RST_Pin, GPIO_PIN_SET);
  HAL_Delay(100);

  set_Freq(868);
  set_config();
  set_LoRa_mode();

  set_OPMODE(OPMODE_STANDBY);
  Write_Reg(RegPaRamp, (Read_Reg(RegPaRamp)& 0xF0) | 0x80 );
  set_Power(23);



  while (1)
  {

//	set_OPMODE(OPMODE_RX);
//	HAL_Delay(15);
//	Receive(rx_data);
//	printf("test : %s \r\n" , rx_data);

	Transmit(tx_data, strlen((char *)tx_data));

	HAL_Delay(400);
    /* USER CODE END WHILE */

    /* USER CODE BEGIN 3 */
  }
  /* USER CODE END 3 */
}

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
