Krystian-Matusiak/Praca_inzynierska/(commit log)

2021-07-09 Radio Tx and Rx SPI
2021-07-12 Kitchen hall and garage scheme
2021-07-14 Correct temp, incorrect pressure
    [main.c]
2021-07-16 Radio modules for both stm32 and scheme correct
    [NRF905_Radio_Module.ioc, NTF905_Radio_STM32F411.ioc, main.c, main.h]
2021-08-12 LoRa transmission test for STM32F303K8
2021-08-25 LoRa synchronization
    [Kitchen_Hall_Garage_Rooms Debug.cfg]
2021-08-27 LoRa switching Tx-Rx STM32-RPi
2021-11-03 Schema corrections
    [Kitchen_Hall_Garage_Rooms.sch, Living_Bath_Bed_Rooms.sch]
2022-01-11 Final version
    [Kitchen_Hall_Garage_Rooms.sch, Living_Bath_Bed_Rooms.sch]
